BenDunselman/wekker/wekker/behuizing/French-Drocourt-carriage-clock-rococo-case-antique-clock-Sevres-porcelain-gilt-bronze-1-1.jpg

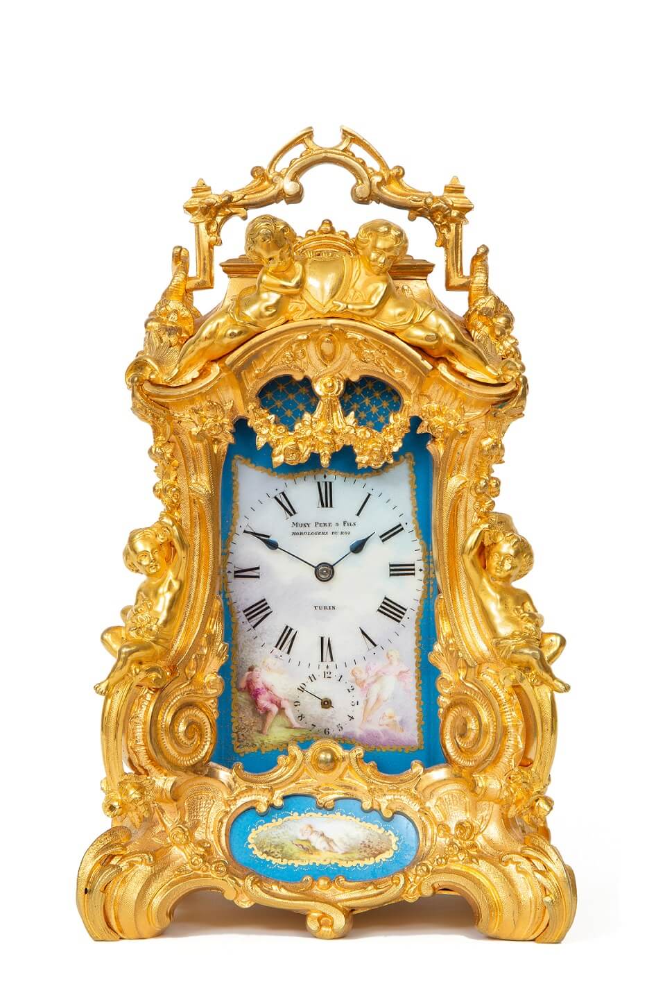
wekker/behuizing/French-Drocourt-carriage-clock-rococo-case-antique-clock-Sevres-porcelain-gilt-bronze-1-1.jpg
