BenDunselman/wekker/wekker/behuizing/32444960-clock-face.jpg

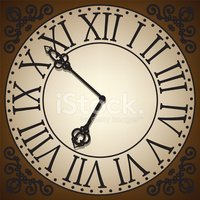
wekker/behuizing/32444960-clock-face.jpg
