BenDunselman/wekker/wekker/behuizing/klokbovenkant.docx

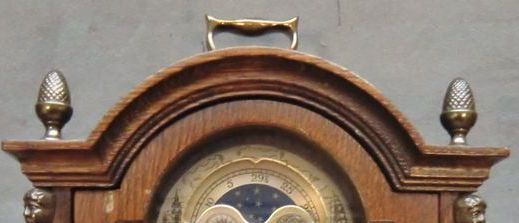
[picture p21: figure]
