BenDunselman/wekker/wekker/behuizing/klokface.docx

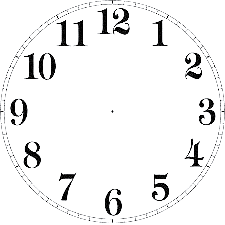
[picture p22: figure]
