BenDunselman/wekker/wekker/behuizing/47777174-clock-face.jpg

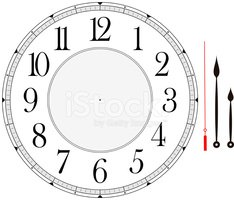
wekker/behuizing/47777174-clock-face.jpg
