BenDunselman/wekker/wekker/behuizing/download.jpg

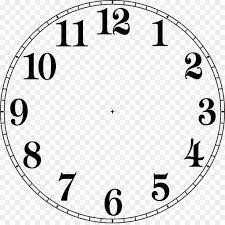
wekker/behuizing/download.jpg
