BenDunselman/wekker/wekker/behuizing/fa67bad4-7a26-11e4-8685-7d9f837d8694.jpg

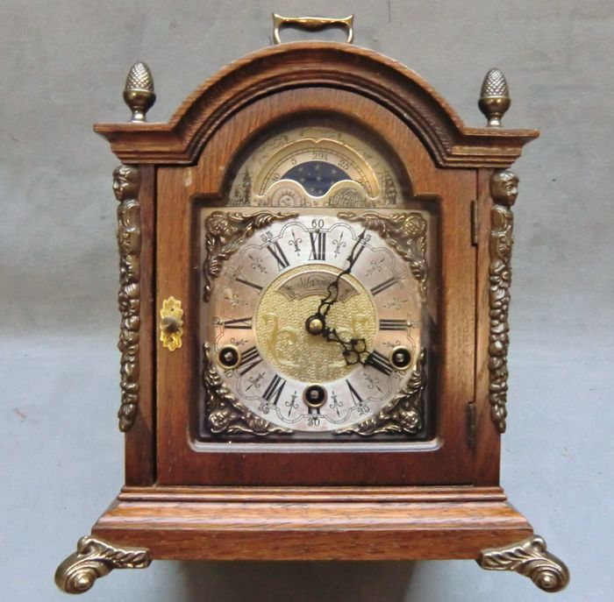
wekker/behuizing/fa67bad4-7a26-11e4-8685-7d9f837d8694.jpg
