BenDunselman/wekker/wekker/behuizing/thumbnail_20211218_171100.jpg

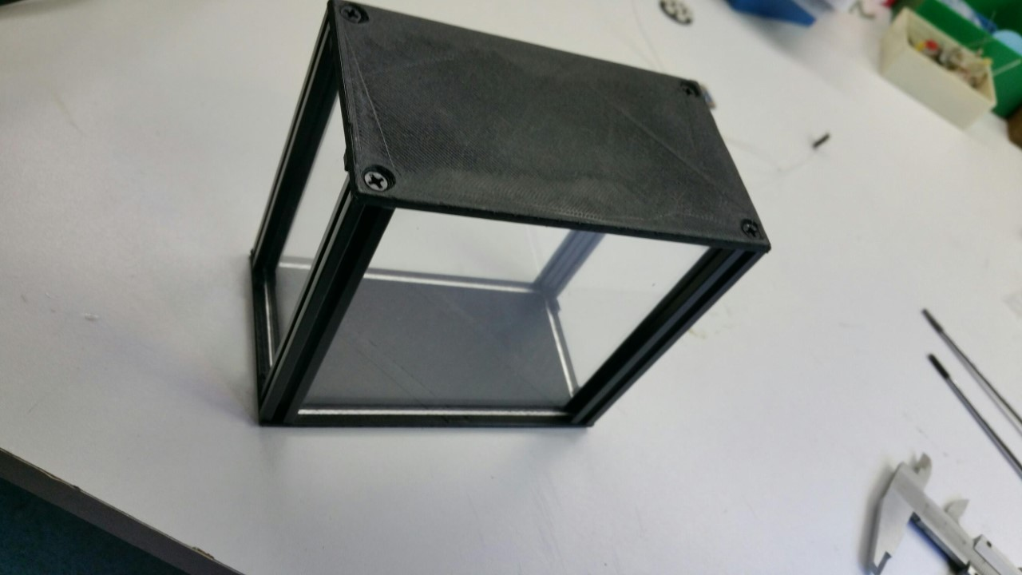
wekker/behuizing/thumbnail_20211218_171100.jpg
