BenDunselman/wekker/wekker/radio_en_amp/rrd-102BC app note.jpg

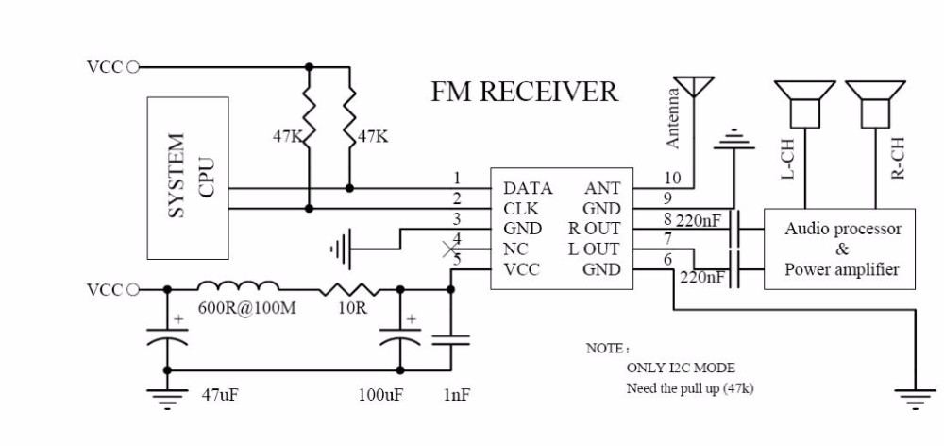
wekker/radio_en_amp/rrd-102BC app note.jpg
