BenDunselman/wekker/wekker/radio_en_amp/rrd-102bc pinout.jpg

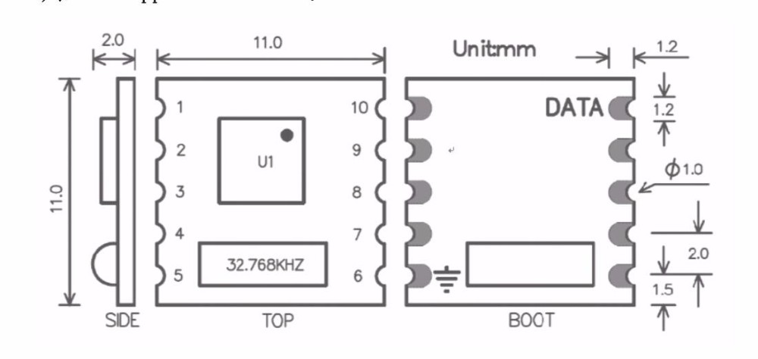
wekker/radio_en_amp/rrd-102bc pinout.jpg
