BenDunselman/wekker/wekker/software/design/WekkerFSM.drawio.png

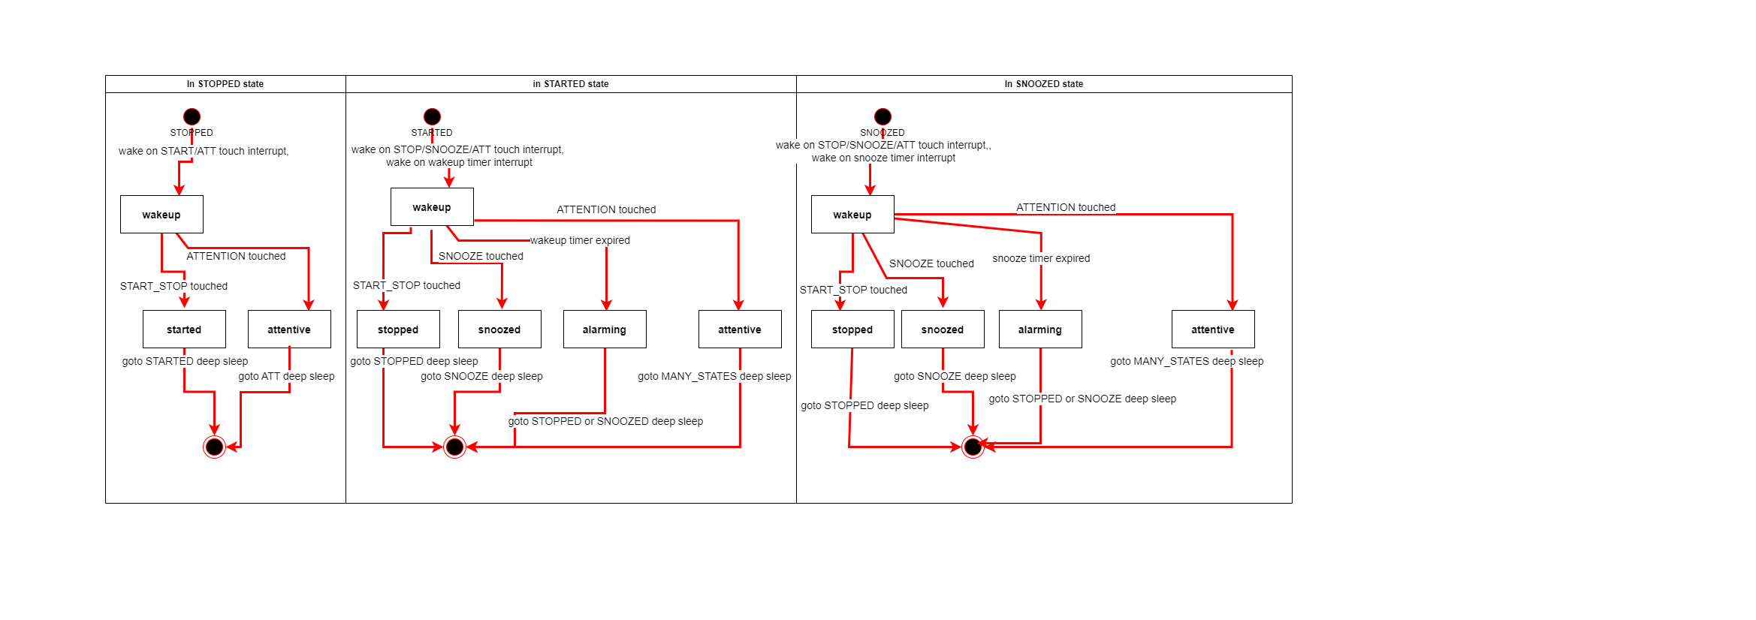
wekker/software/design/WekkerFSM.drawio.png
