BenDunselman/wekker/wekker/behuizing/speaker_support.stl

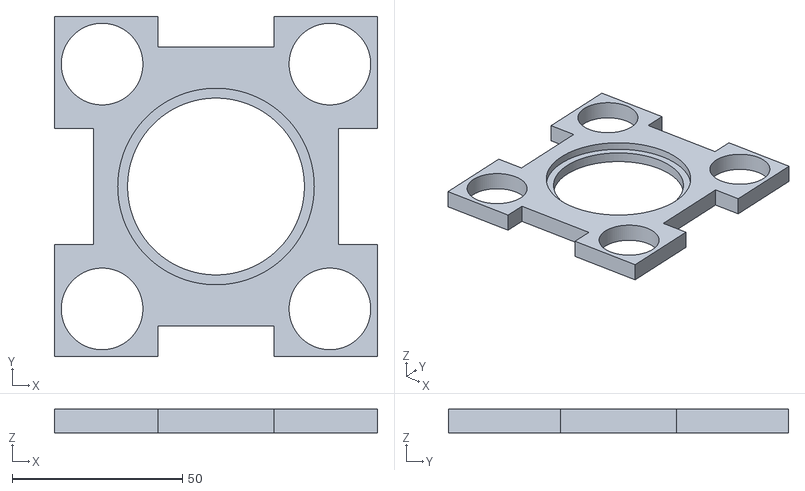
[picture p30: CAD file, 2022-12-04]
wekker/behuizing/speaker_support.stl
95.0 x 100.0 x 7.00
