BenDunselman/wekker/wekker/behuizing/display_en_pcb_support.stl

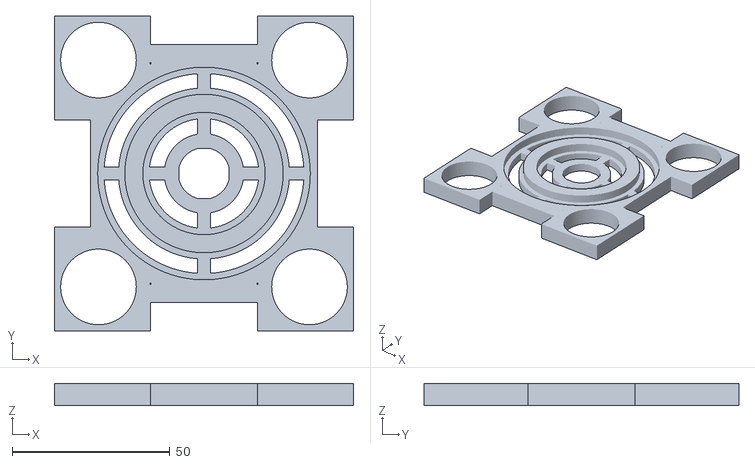
[picture p31: CAD file, 2022-12-04]
wekker/behuizing/display_en_pcb_support.stl
95.0 x 100.0 x 7.00
