BenDunselman/wekker/wekker/behuizing/brackets.stl

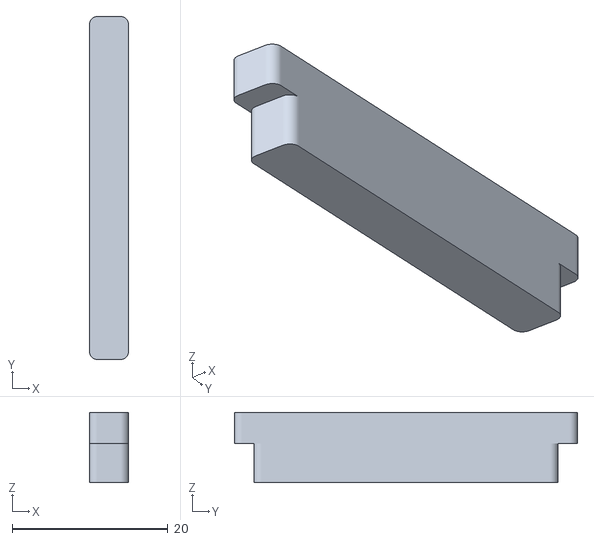
[picture p32: CAD file, 2022-12-04]
wekker/behuizing/brackets.stl
5.00 x 44.0 x 9.00
