BenDunselman/wekker/wekker/behuizing/klokkap.stl

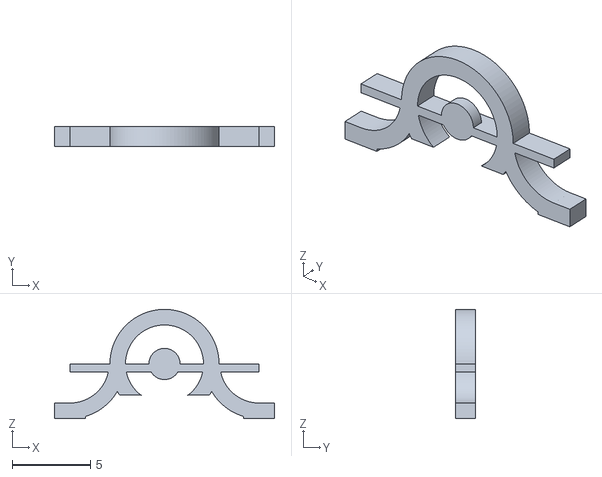
[picture p33: CAD file, 2022-12-04]
wekker/behuizing/klokkap.stl
14.1 x 1.30 x 7.00
