BenDunselman/wekker/wekker/behuizing/voetstuk.stl

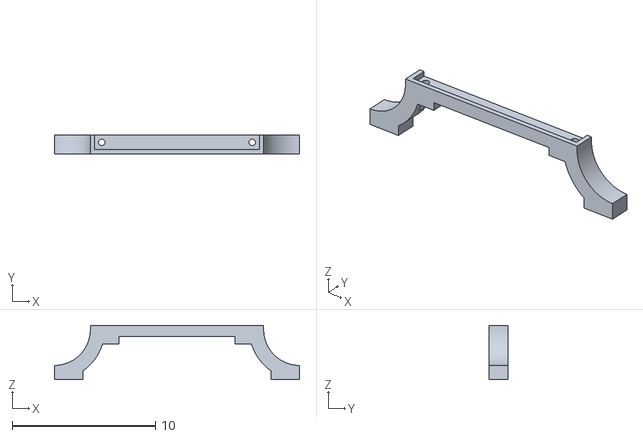
[picture p34: CAD file, 2022-12-04]
wekker/behuizing/voetstuk.stl
17.1 x 1.30 x 3.80
