BenDunselman/wekker/wekker/behuizing/brackets2.stl

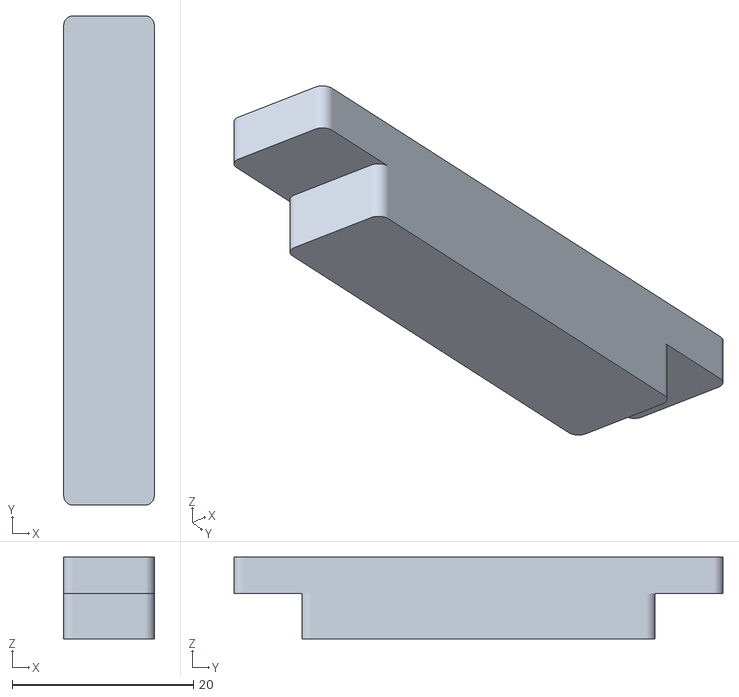
[picture p35: CAD file, 2022-12-04]
wekker/behuizing/brackets2.stl
10.0 x 54.0 x 9.00
