BenDunselman/wekker/wekker/behuizing/brackets2.scad

$fn=90;

module top() {
     translate([1,-26,5]) {
         minkowski() {
            cube([8, 52, 3], center=false);
            cylinder(1);
         }
     }      
}

module bottom() {
     translate([1,-18.5,0]) {
         minkowski() {
            cube([8, 37, 5], center=false);
            cylinder(1);
         }
     }      
}

module bracket() {
    union() {
        top();
        bottom();
    }
}

bracket();
