BenDunselman/wekker/(list of files, cad)

Other CAD files:
wekker/behuizing/speaker_support.scad
wekker/behuizing/voetstuk.scad
