BenDunselman/wekker/wekker/display/ring24.brd

## EAGLE design wekker/display/ring24.brd (2022-12-04)

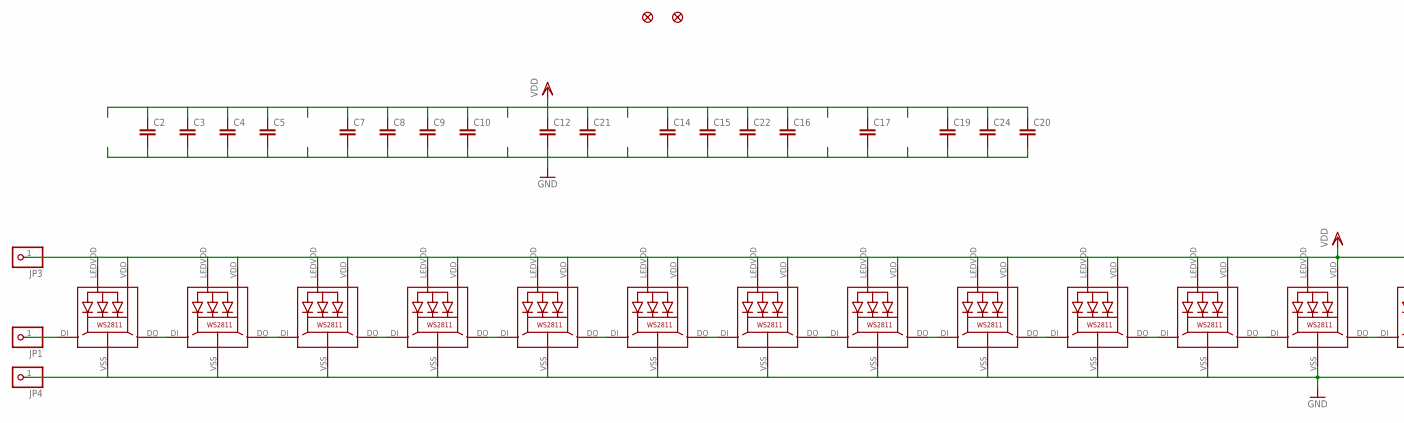
[picture p36: schematic ring24.sch, part in row 1, column 1]

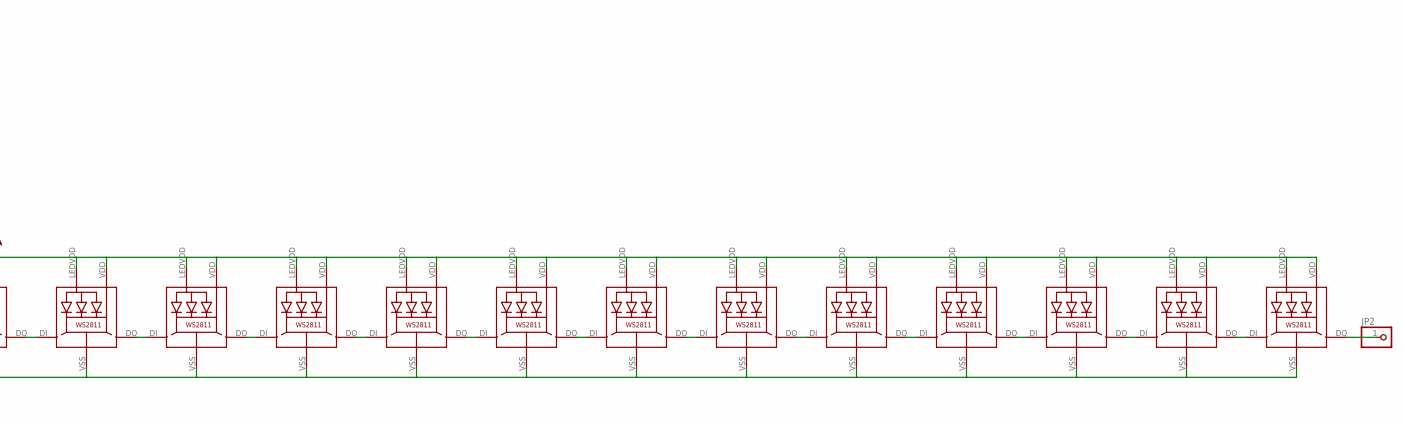
[picture p37: schematic ring24.sch, part in row 1, column 2]

Parts:
C2, C3, C4, C5, C7, C8, C9, C10, C12, C14, C15, C16, C17, C19, C20, C21, C22, C24: C-EUC0603; C0603
FID1, FID2: FIDUCIAL""; FIDUCIAL_1MM
JP1, JP2, JP3, JP4: PINHD-1X1CB; 1X01-CLEANBIG
LED1, LED2, LED3, LED4, LED5, LED6, LED7, LED8, LED9, LED10, LED11, LED12, LED13, LED14, LED15, LED16, LED17, LED18, LED19, LED20, LED21, LED22, LED23, LED24: WS28115050

Connections:
GND: C2.2, C3.2, C4.2, C5.2, C7.2, C8.2, C9.2, C10.2, C12.2, C14.2, C15.2, C16.2, C17.2, C19.2, C20.2, C21.2, C22.2, C24.2, JP4.1, LED1.VSS (GND), LED2.VSS (GND), LED3.VSS (GND), LED4.VSS (GND), LED5.VSS (GND), LED6.VSS (GND), LED7.VSS (GND), LED8.VSS (GND), LED9.VSS (GND), LED10.VSS (GND), LED11.VSS (GND), LED12.VSS (GND), LED13.VSS (GND), LED14.VSS (GND), LED15.VSS (GND), LED16.VSS (GND), LED17.VSS (GND), LED18.VSS (GND), LED19.VSS (GND), LED20.VSS (GND), LED21.VSS (GND), LED22.VSS (GND), LED23.VSS (GND), LED24.VSS (GND)
unnamed: LED1.DO, LED2.DI
unnamed: LED2.DO, LED3.DI
unnamed: LED3.DO, LED4.DI
unnamed: LED4.DO, LED5.DI
unnamed: LED5.DO, LED6.DI
unnamed: LED6.DO, LED7.DI
unnamed: LED7.DO, LED8.DI
unnamed: LED8.DO, LED9.DI
unnamed: LED9.DO, LED10.DI
unnamed: LED10.DO, LED11.DI
unnamed: LED11.DO, LED12.DI
unnamed: LED12.DO, LED13.DI
unnamed: LED13.DO, LED14.DI
unnamed: LED14.DO, LED15.DI
unnamed: LED15.DO, LED16.DI
unnamed: LED16.DO, LED17.DI
unnamed: LED17.DO, LED18.DI
unnamed: LED18.DO, LED19.DI
unnamed: LED19.DO, LED20.DI
unnamed: LED20.DO, LED21.DI
unnamed: LED21.DO, LED22.DI
unnamed: LED22.DO, LED23.DI
unnamed: LED23.DO, LED24.DI
unnamed: JP2.1, LED24.DO
unnamed: JP1.1, LED1.DI
VDD: C2.1, C3.1, C4.1, C5.1, C7.1, C8.1, C9.1, C10.1, C12.1, C14.1, C15.1, C16.1, C17.1, C19.1, C20.1, C21.1, C22.1, C24.1, JP3.1, LED1.LEDVDD, LED1.VDD, LED2.LEDVDD, LED2.VDD, LED3.LEDVDD, LED3.VDD, LED4.LEDVDD, LED4.VDD, LED5.LEDVDD, LED5.VDD, LED6.LEDVDD, LED6.VDD, LED7.LEDVDD, LED7.VDD, LED8.LEDVDD, LED8.VDD, LED9.LEDVDD, LED9.VDD, LED10.LEDVDD, LED10.VDD, LED11.LEDVDD, LED11.VDD, LED12.LEDVDD, LED12.VDD, LED13.LEDVDD, LED13.VDD, LED14.LEDVDD, LED14.VDD, LED15.LEDVDD, LED15.VDD, LED16.LEDVDD, LED16.VDD, LED17.LEDVDD, LED17.VDD, LED18.LEDVDD, LED18.VDD, LED19.LEDVDD, LED19.VDD, LED20.LEDVDD, LED20.VDD, LED21.LEDVDD, LED21.VDD, LED22.LEDVDD, LED22.VDD, LED23.LEDVDD, LED23.VDD, LED24.LEDVDD, LED24.VDD

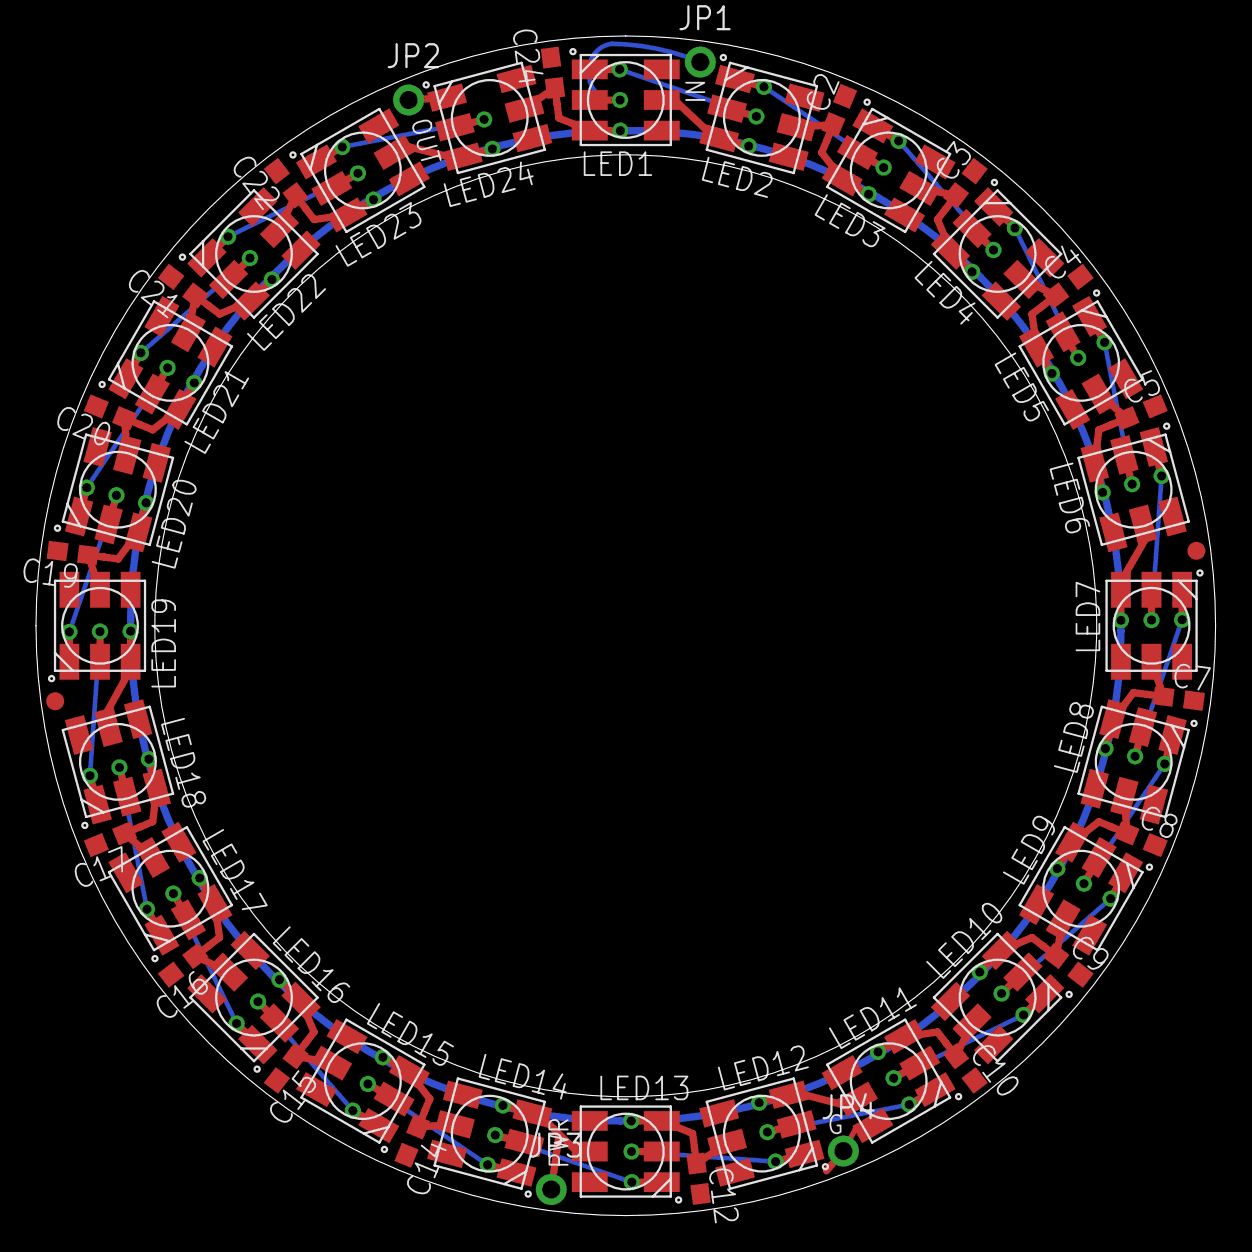
[picture p38: board ring24.brd from above]

Board: 2 copper layers, 65.5 x 65.5 mm, 49 parts (1 on the bottom side), 27 nets.

Other parts of the board:
U$1: ADAFRUIT_5MM
